jbeuckm/Roland-121-VCF/README.md

# Roland-121-VCF
Based on http://www.frequencycentral.co.uk/wp-content/uploads/2012/05/Roland-121-VCF-Build-Doc.pdf

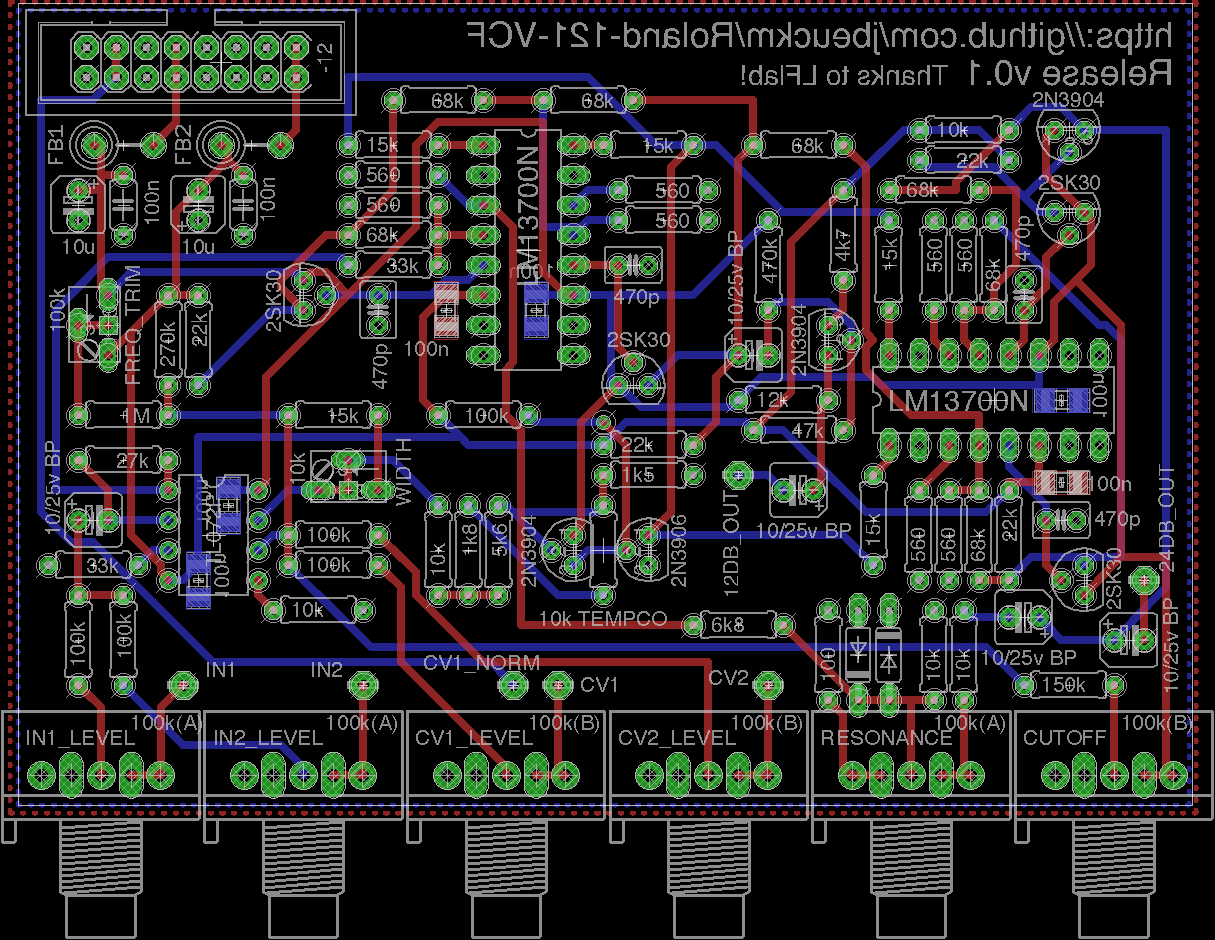
[picture p1: Roland_121_VCF_layout.png]
