jbeuckm/Roland-121-VCF/panel/r121_vcf_panel.stl

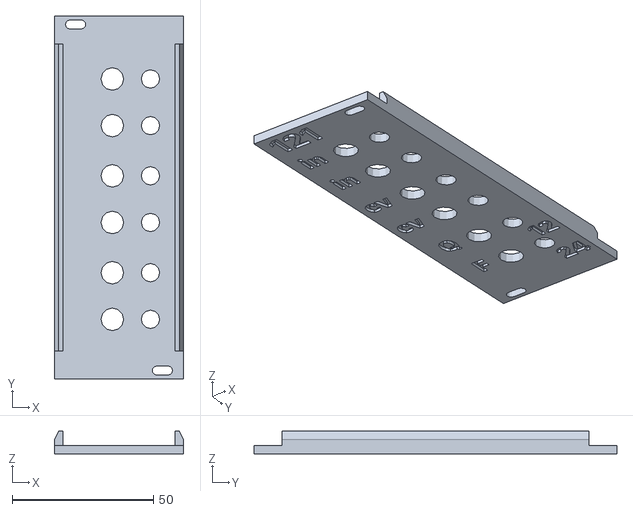
[picture p2: CAD file, 2017-12-18]
panel/r121_vcf_panel.stl
45.7 x 128.5 x 8.00
