jbeuckm/Roland-121-VCF/eagle/roland_121_vcf.brd

## EAGLE design eagle/roland_121_vcf.brd (2017-11-12)

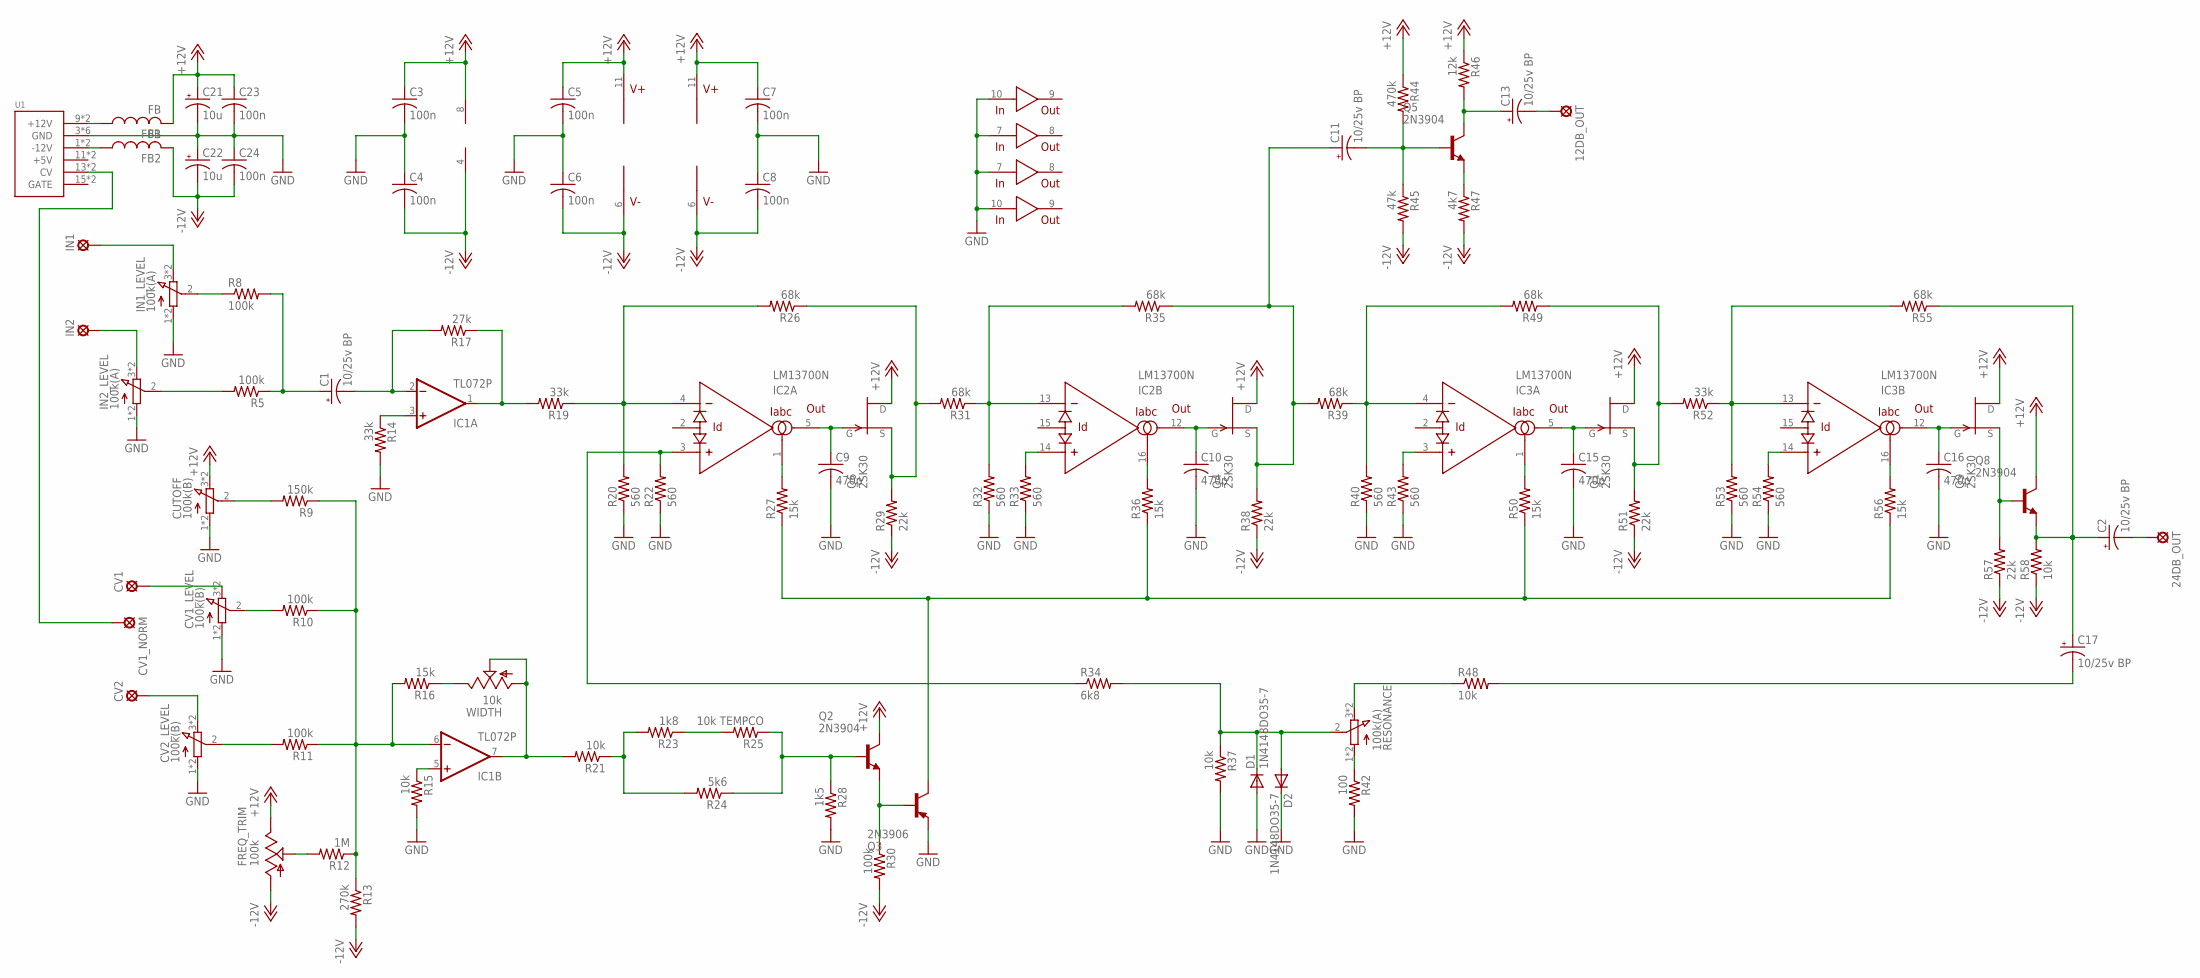
[picture p3: schematic roland_121_vcf.sch]

Parts:
12DB_OUT, 24DB_OUT: LSP10
C1, C2, C11, C13, C17: 10/25v BP; B45181A
C3, C4, C5, C6, C7, C8: 100n; C1206
C9, C10, C15, C16: 470p; C025-030X050
C21, C22: 10u; B45181A
C23, C24: 100n; C050-024X044
CUTOFF: 100k(B); 3RP/1610N
CV1, CV1_NORM, CV2: LSP10
CV1_LEVEL, CV2_LEVEL: 100k(B); 3RP/1610N
D1, D2: 1N4148DO35-7; DO35-7
FB1, FB2: FB
FREQ_TRIM: 100k; B64W
IC1: TL072P; DIL08
IC2, IC3: LM13700N; DIL16
IN1, IN2: LSP10
IN1_LEVEL, IN2_LEVEL: 100k(A); 3RP/1610N
Q1, Q4, Q6, Q9: 2SK30; TO92
Q2, Q5, Q8: 2N3904; TO92
Q3: 2N3906; TO92
R5, R8, R10, R11, R30: 100k; 0207/7
R9: 150k; 0207/7
R12: 1M; 0207/7
R13: 270k; 0207/7
R14, R19, R52: 33k; 0207/7
R15, R21, R37, R48, R58: 10k; 0207/7
R16, R27, R36, R50, R56: 15k; 0207/7
R17: 27k; 0207/7
R20, R22, R32, R33, R40, R43, R53, R54: 560; 0207/7
R23: 1k8; 0207/7
R24: 5k6; 0207/7
R25: 10k TEMPCO; 0207/7
R26, R31, R35, R39, R49, R55: 68k; 0207/7
R28: 1k5; 0207/7
R29, R38, R51, R57: 22k; 0207/7
R34: 6k8; 0207/7
R42: 100; 0207/7
R44: 470k; 0207/7
R45: 47k; 0207/7
R46: 12k; 0207/7
R47: 4k7; 0207/7
RESONANCE: 100k(A); 3RP/1610N
U1: POWER; POWER_16
WIDTH: 10k; B64W

Connections:
+12V: C3.1, C5.1, C7.1, C21.+, C23.1, CUTOFF.3 (E), CUTOFF.6 (E), FB1.P$2 (2), FREQ_TRIM.E, IC1.8 (V+), IC2.11 (V+), IC3.11 (V+), Q1.1 (D), Q2.1 (C), Q4.1 (D), Q6.1 (D), Q8.1 (C), Q9.1 (D), R44.1, R46.1
-12V: C4.2, C6.2, C8.2, C22.-, C24.2, FB2.P$2 (2), FREQ_TRIM.A, IC1.4 (V-), IC2.6 (V-), IC3.6 (V-), R13.2, R29.1, R30.2, R38.1, R45.2, R47.2, R51.1, R57.1, R58.1
GND: C3.2, C4.1, C5.2, C6.1, C7.2, C8.1, C9.2, C10.2, C15.2, C16.2, C21.-, C22.+, C23.2, C24.1, CUTOFF.1 (A), CUTOFF.4 (A), CV1_LEVEL.1 (A), CV1_LEVEL.4 (A), CV2_LEVEL.1 (A), CV2_LEVEL.4 (A), D1.A, D2.C, IC2.7 (IN), IC2.10 (IN), IC3.7 (IN), IC3.10 (IN), IN1_LEVEL.1 (A), IN1_LEVEL.4 (A), IN2_LEVEL.1 (A), IN2_LEVEL.4 (A), Q3.3 (E), R14.2, R15.2, R20.1, R22.1, R28.2, R32.1, R33.1, R37.2, R40.1, R42.2, R43.1, R53.1, R54.1, U1.3 (GND), U1.4 (GND), U1.5 (GND), U1.6 (GND), U1.7 (GND), U1.8 (GND)
unnamed: IC2.1 (IABC), R27.2
unnamed: IC2.16 (IABC), R36.2
unnamed: IC2.13 (-IN), R31.1, R32.2, R35.2
unnamed: IC2.14 (+IN), R33.2
unnamed: IN2_LEVEL.2 (S), R5.2
unnamed: C1.+, R5.1, R8.2
unnamed: C1.-, IC1.2 (-IN), R17.2
unnamed: IC1.1 (OUT), R17.1, R19.2
unnamed: R16.1, WIDTH.E
unnamed: CV2_LEVEL.2 (S), R11.2
unnamed: IC1.3 (+IN), R14.1
unnamed: IC1.5 (+IN), R15.1
unnamed: IC3.1 (IABC), R50.2
unnamed: IC3.4 (-IN), R39.1, R40.2, R49.2
unnamed: IC1.6 (-IN), R9.1, R10.1, R11.1, R12.1, R13.1, R16.2
unnamed: FREQ_TRIM.P$1 (S), FREQ_TRIM.S, R12.2
unnamed: R23.1, R25.2
unnamed: R21.1, R23.2, R24.2
unnamed: Q2.2 (B), R24.1, R25.1, R28.1
unnamed: Q2.3 (E), Q3.2 (B), R30.1
unnamed: IC2.4 (-IN), R19.1, R20.2, R26.2
unnamed: IC2.3 (+IN), R22.2, R34.1
unnamed: IC3.3 (+IN), R43.2
unnamed: IC3.16 (IABC), R56.2
unnamed: IC3.13 (-IN), R52.1, R53.2, R55.2
unnamed: IC3.14 (+IN), R54.2
unnamed: Q6.3 (S), R26.1, R29.2, R31.2
unnamed: 24DB_OUT.MP, C2.-
unnamed: 12DB_OUT.MP, C13.-
unnamed: Q5.3 (E), R47.1
unnamed: C13.+, Q5.1 (C), R46.2
unnamed: C11.-, Q5.2 (B), R44.2, R45.1
unnamed: IN2.MP, IN2_LEVEL.3 (E), IN2_LEVEL.6 (E)
unnamed: C11.+, Q4.3 (S), R35.1, R38.2, R39.2
unnamed: C2.+, C17.+, Q8.3 (E), R55.1, R58.2
unnamed: Q1.3 (S), R49.1, R51.2, R52.2
unnamed: IC1.7 (OUT), R21.2, WIDTH.A, WIDTH.P$1 (S), WIDTH.S
unnamed: C9.1, IC2.5 (OUT), Q6.2 (G)
unnamed: C10.1, IC2.12 (OUT), Q4.2 (G)
unnamed: C15.1, IC3.5 (OUT), Q1.2 (G)
unnamed: C16.1, IC3.12 (OUT), Q9.2 (G)
unnamed: Q3.1 (C), R27.1, R36.1, R50.1, R56.1
unnamed: Q8.2 (B), Q9.3 (S), R57.2
unnamed: R42.1, RESONANCE.1 (A), RESONANCE.4 (A)
unnamed: C17.-, R48.2
unnamed: R48.1, RESONANCE.3 (E), RESONANCE.6 (E)
unnamed: D1.C, D2.A, R34.2, R37.1, RESONANCE.2 (S)
unnamed: CV1_LEVEL.2 (S), R10.2
unnamed: CV2.MP, CV2_LEVEL.3 (E), CV2_LEVEL.6 (E)
unnamed: CV1_NORM.MP, U1.13 (CV), U1.14 (CV)
unnamed: CUTOFF.2 (S), R9.2
unnamed: IN1_LEVEL.2 (S), R8.1
unnamed: IN1.MP, IN1_LEVEL.3 (E), IN1_LEVEL.6 (E)
unnamed: CV1.MP, CV1_LEVEL.3 (E), CV1_LEVEL.6 (E)
unnamed: FB1.P$1 (1), U1.9 (+12V), U1.10 (+12V)
unnamed: FB2.P$1 (1), U1.1 (-12V), U1.2 (-12V)

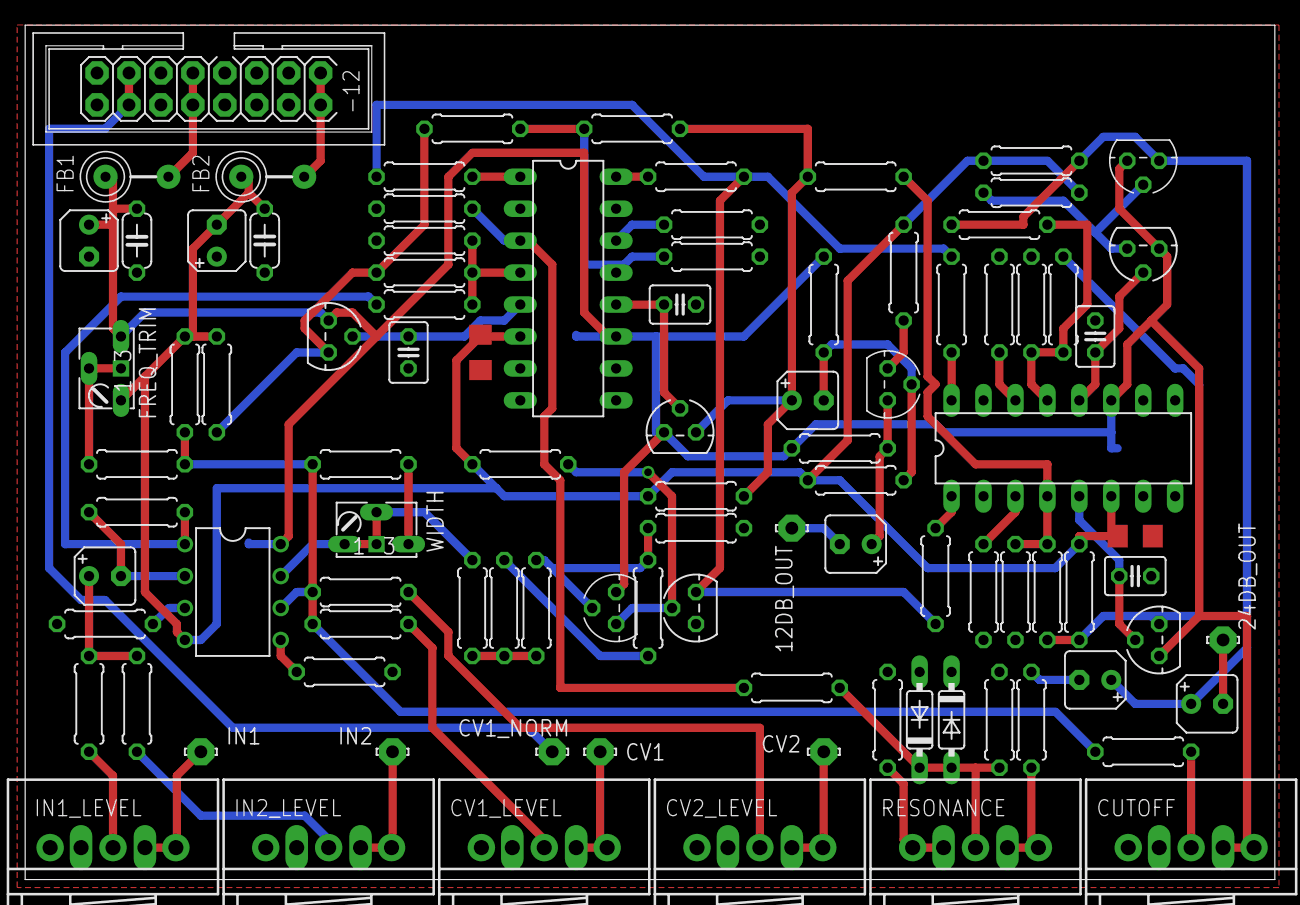
[picture p4: board roland_121_vcf.brd from above]

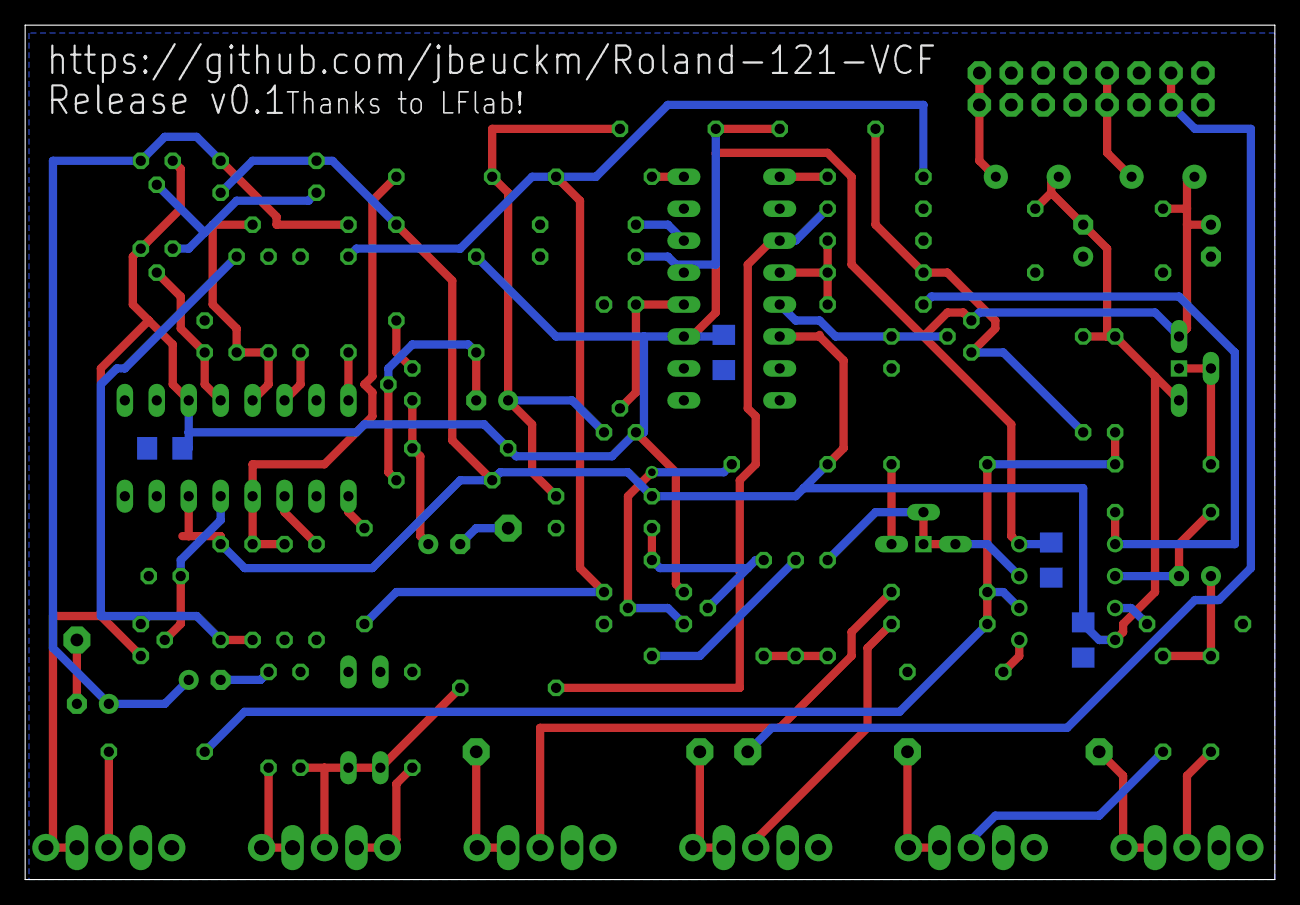
[picture p5: board roland_121_vcf.brd from below]

Board: 2 copper layers, 99.4 x 67.9 mm, 100 parts (4 on the bottom side), 59 nets.
