jbeuckm/Roland-121-VCF/(commit log)

2015-10-07 working on layout
    [roland_121_vcf.brd, roland_121_vcf_with_12db.brd, roland_121_vcf_with_12db.sch]
2015-10-08 layout progress
    [roland_121_vcf_with_12db.brd, roland_121_vcf_with_12db.sch]
2017-08-24 starting over with updated techniques
    [roland_121_vcf.brd, roland_121_vcf.sch, roland_121_vcf_with_12db.brd, roland_121_vcf_with_12db.sch]
2017-08-24 layout begins
    [roland_121_vcf.brd]
2017-08-24 parts on
    [roland_121_vcf.brd]
2017-08-24 draft routed
    [roland_121_vcf.brd]
2017-08-24 changed FET to 2sk30a
    [roland_121_vcf.brd, roland_121_vcf.sch]
2017-08-25 ground planes
    [roland_121_vcf.brd]
2017-08-26 cleaned up silkscreen
    [roland_121_vcf.brd, roland_121_vcf.sch]
2017-08-27 smt decouplers, shrouded power, 16 or 9mm pots
    [roland_121_vcf.brd, roland_121_vcf.sch]
2017-09-01 now with flexible trimmer pinout
    [roland_121_vcf.brd, roland_121_vcf.sch]
2017-09-02 label tweaks
    [roland_121_vcf.brd]
2017-11-12 fixed the wrong valued resistor
    [r121_vcf_panel.scad, roland_121_vcf.brd, roland_121_vcf.sch]
2017-11-12 knob spacing
    [r121_vcf_panel.scad]
2017-11-12 panel try
    [r121_vcf_panel.scad, r121_vcf_panel.stl]
2017-12-18 updated panel to 3mm
    [r121_vcf_panel.scad, r121_vcf_panel.stl]
